hippieua/esphome-powmr-hybrid-inverter/pcb/pro/Invertor2HA v17.pdf

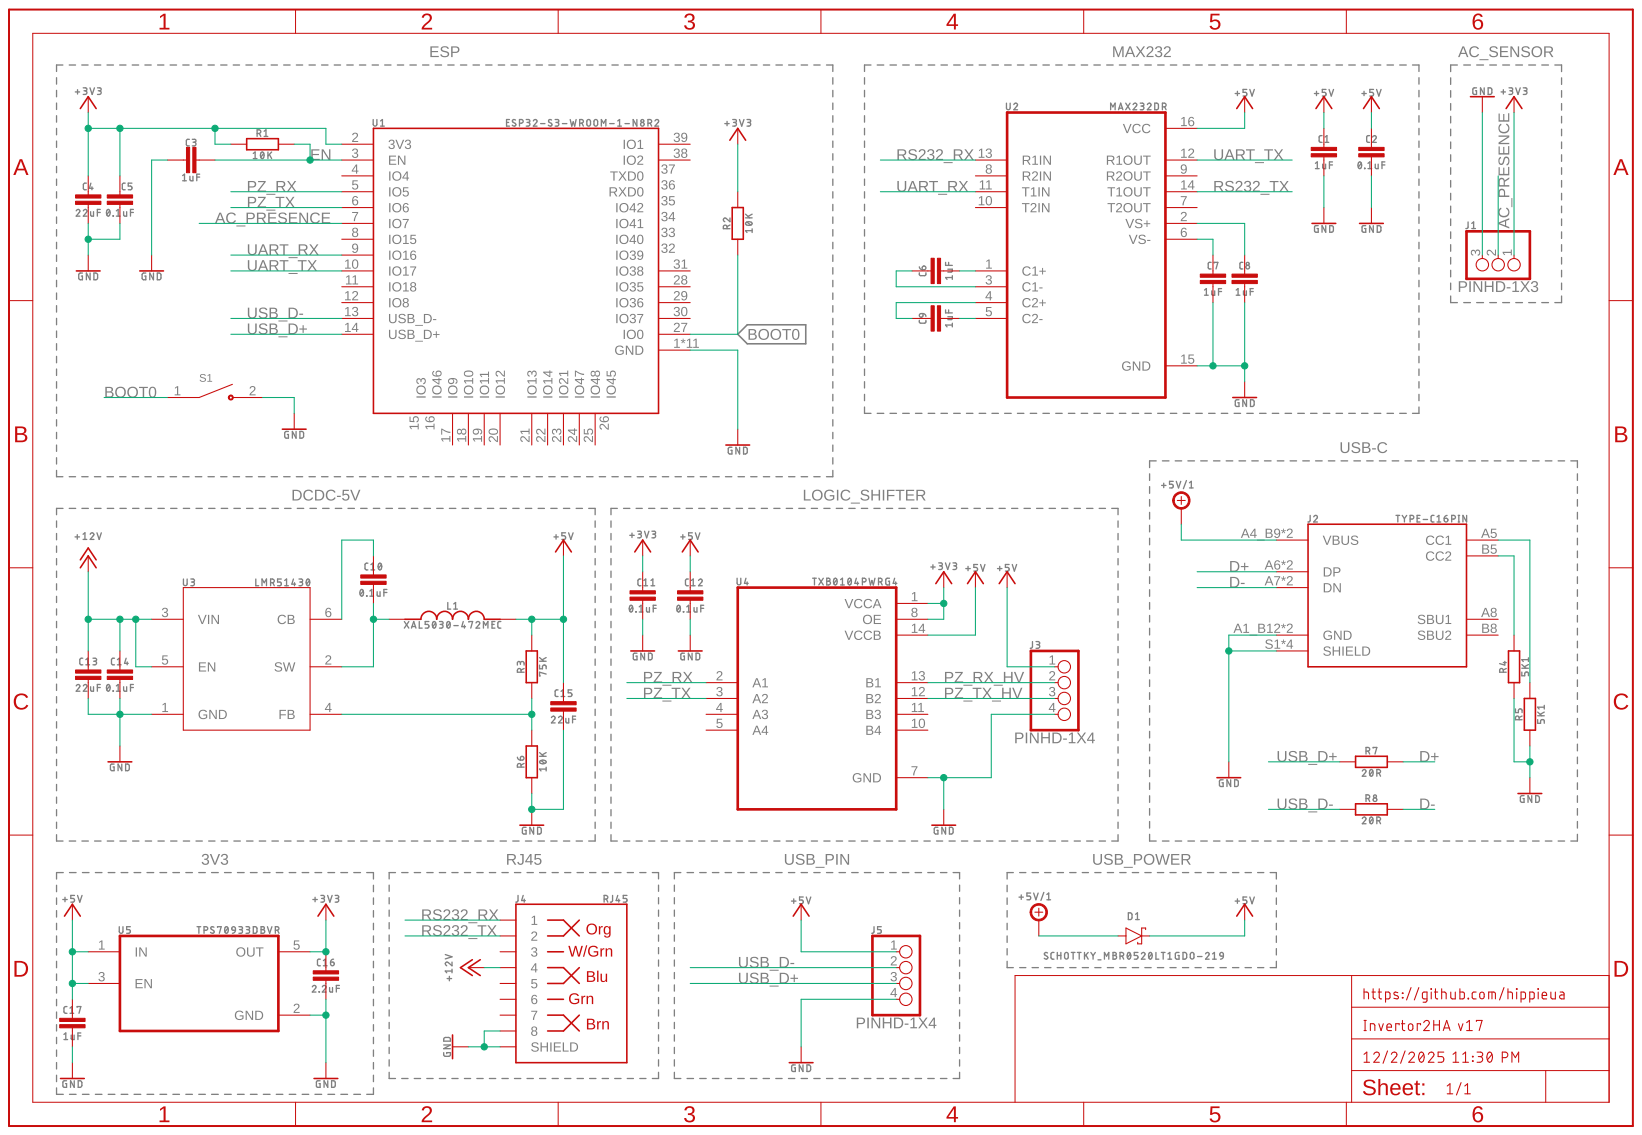
[picture p6: page 1]
