hippieua/esphome-powmr-hybrid-inverter/pcb/pro/case/top.stl

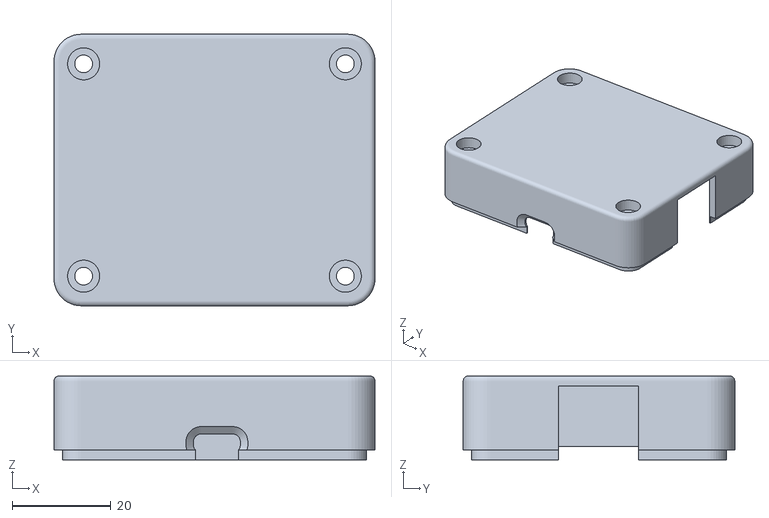
[picture p4: CAD file, 2025-12-02]
pcb/pro/case/top.stl
65.0 x 55.0 x 17.0
