hippieua/esphome-powmr-hybrid-inverter/pcb/pro/case/bottom.stl

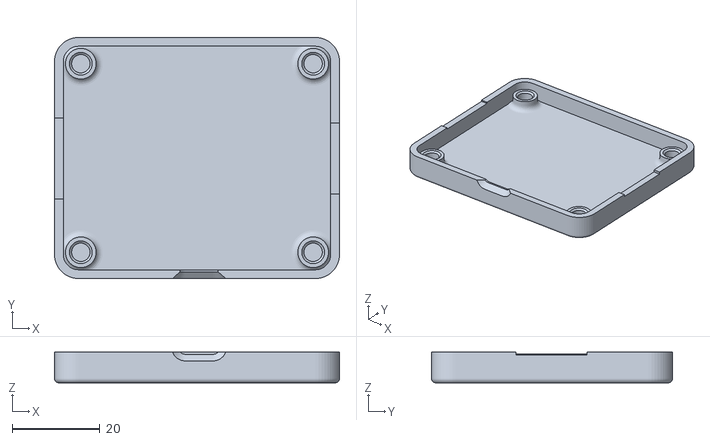
[picture p5: CAD file, 2025-12-02]
pcb/pro/case/bottom.stl
65.0 x 55.0 x 7.00
